fanfanlatulipe26/talking_variometer_altimeter/list_of_languages.txt

List of  languages supported by gTTS.
Results of the Python script:
import gtts.lang
d=gtts.lang.tts_langs()
print(d)
for k, v in d.items():
    print(k, v)

Printed in January 2023.

af Afrikaans
ar Arabic
bg Bulgarian
bn Bengali
bs Bosnian
ca Catalan
cs Czech
da Danish
de German
el Greek
en English
es Spanish
et Estonian
fi Finnish
fr French
gu Gujarati
hi Hindi
hr Croatian
hu Hungarian
id Indonesian
is Icelandic
it Italian
iw Hebrew
ja Japanese
jw Javanese
km Khmer
kn Kannada
ko Korean
la Latin
lv Latvian
ml Malayalam
mr Marathi
ms Malay
my Myanmar (Burmese)
ne Nepali
nl Dutch
no Norwegian
pl Polish
pt Portuguese
ro Romanian
ru Russian
si Sinhala
sk Slovak
sq Albanian
sr Serbian
su Sundanese
sv Swedish
sw Swahili
ta Tamil
te Telugu
th Thai
tl Filipino
tr Turkish
uk Ukrainian
ur Urdu
vi Vietnamese
zh-CN Chinese (Simplified)
zh-TW Chinese (Mandarin/Taiwan)
zh Chinese (Mandarin)
