fanfanlatulipe26/talking_variometer_altimeter/(commit log)

2026-06-01 local copy of toneAC library
    local copy of toneAC library
    The original library seems no longer available on github, with Arduino library manager
    [toneAC_demo.ino, toneAC_dual_LED.ino]
2026-06-01 Update toneAC library installation note in README
    toneAC no longer available from Arduino library manager ?
